rusefi/hw_55_te/version.txt

# this file is related to https://github.com/rusefi/kicad-libraries/blob/master/generate_diffs.sh
0.0
