rusefi/hw_55_te/microrusefi55adapter.pdf

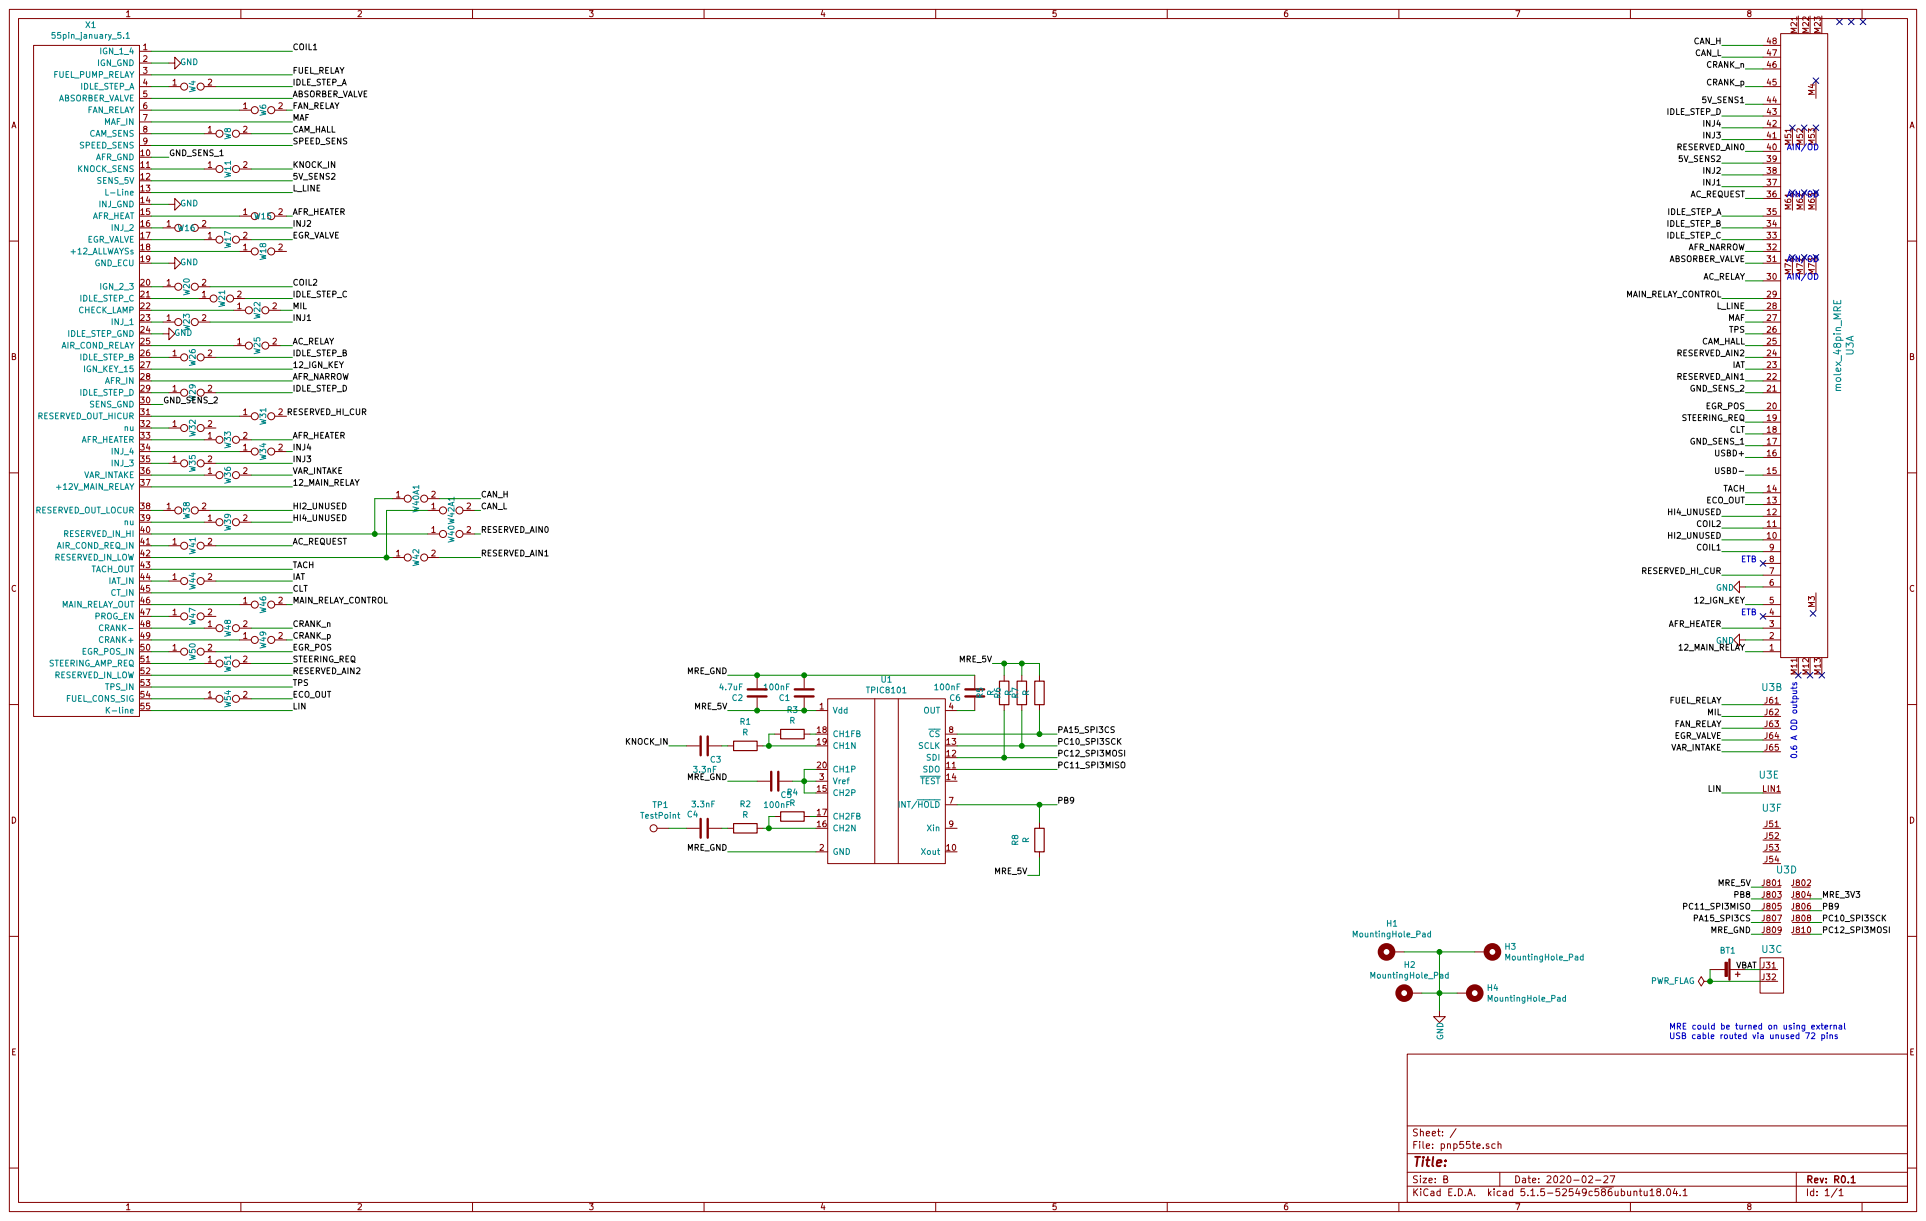
[picture p2: page 1]

MRE could be turned on using external
USB cable routed via unused 72 pins
