rusefi/hw_55_te/pnp55te.kicad_pcb

## KiCad design pnp55te.kicad_pcb (2020-08-17)

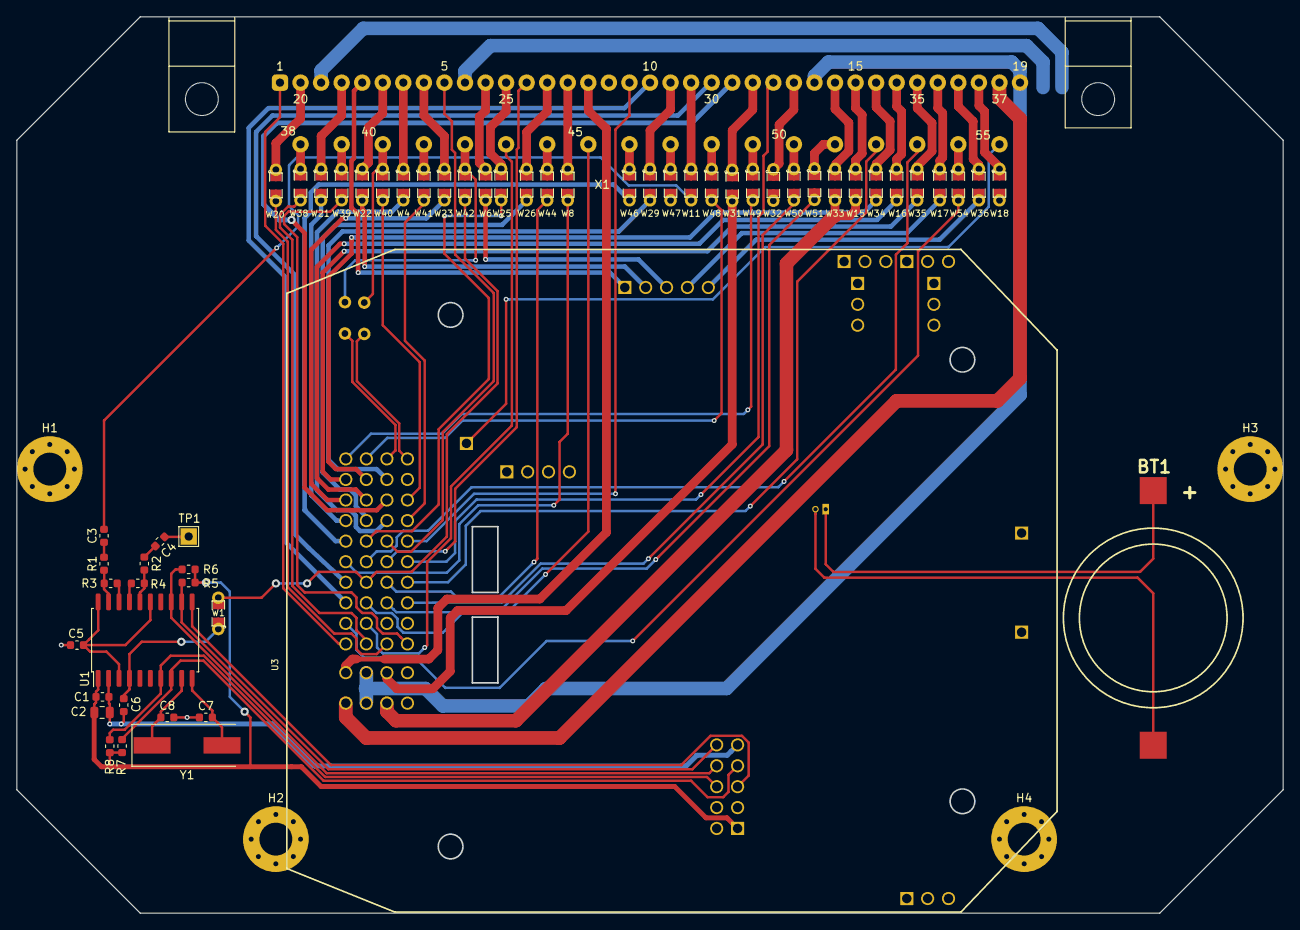
[picture p3: board pnp55te.kicad_pcb from above]

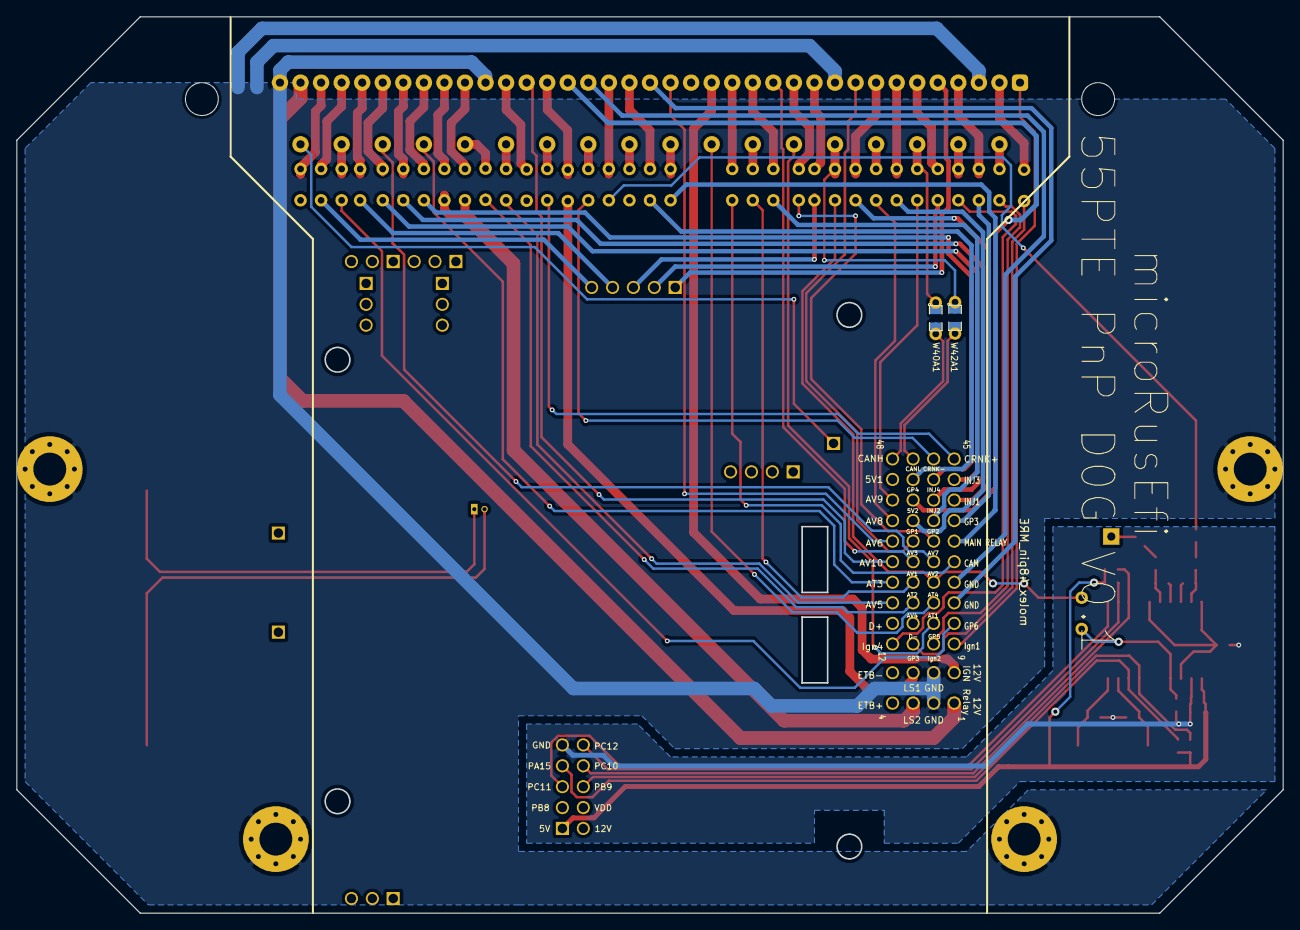
[picture p4: board pnp55te.kicad_pcb from below]

Board: 2 copper layers, 154.0 x 109.0 mm, 63 parts (2 on the bottom side), 103 nets.

Parts:
BT1: Battery_Cell; BATT_CR2032_MPD
C1, C5, C6: 100nF; C_0603_1608Metric
C2: 4.7uF; C_0805_2012Metric
C3, C4: 3.3nF; C_0603_1608Metric
C7, C8: 18pF; C_0603_1608Metric
H1, H2, H3, H4: MountingHole_Pad; MountingHole_4mm_Pad_Via
R1, R2, R3, R4, R5, R6, R7, R8: R; R_0603_1608Metric
TP1: TestPoint; TestPoint_THTPad_2.0x2.0mm_Drill1.0mm
U1: TPIC8101; SOIC-20W_7.5x12.8mm_P1.27mm
U3: molex_48pin_MRE; Molex_48_MRE_clean
W1: n.a. TestPoint_2Pole; SM0805_jumper
W4, W6, W8, W11, W15, W16, W17, W18, W20, W21, W22, W23, W25, W26, W29, W31, W32, W33, W34, W35, W36, W38, W39, W40, W40A1, W41, W42, W42A1, W44, W46, W47, W48, W49, W50, W51, W54: TestPoint_2Pole; SM0805_jumper
X1: 55pin_january_5.1; TE_963063-2
Y1: 8MHz; Crystal_SMD_HC49-SD

Connections:
/5V_SENS2: U3.39, X1.12
/12_IGN_KEY: U3.5, X1.27
/12_MAIN_RELAY: U3.1, X1.37
/ABSORBER_VALVE: U3.31, X1.5
/AC_RELAY: U3.30, W25.2
/AC_REQUEST: U3.36, W41.2
/AFR_HEATER: U3.3, W15.2, W33.2
/AFR_NARROW: U3.32, X1.28
/CAM_HALL: U3.25, W8.2
/CAN_H: U3.48, W40A1.2
/CAN_L: U3.47, W42A1.2
/CLT: U3.18, X1.45
/COIL1: U3.9, X1.1
/COIL2: U3.11, W20.2
/CRANK_n: U3.46, W48.2
/CRANK_p: U3.45, W49.2
/ECO_OUT: U3.13, W54.2
/EGR_POS: U3.20, W50.2
/EGR_VALVE: U3.J64, W17.2
/FAN_RELAY: U3.J63, W6.2
/FUEL_RELAY: U3.J61, X1.3
/GND_SENS_1: U3.17, X1.10
/GND_SENS_2: U3.21, X1.30
/HI2_UNUSED: U3.10, W38.2
/HI4_UNUSED: U3.12, W39.2
/IAT: U3.23, W44.2
/IDLE_STEP_A: U3.35, W4.2
/IDLE_STEP_B: U3.34, W26.2
/IDLE_STEP_C: U3.33, W21.2
/IDLE_STEP_D: U3.43, W29.2
/INJ1: U3.37, W23.2
/INJ2: U3.38, W16.2
/INJ3: U3.41, W35.2
/INJ4: U3.42, W34.2
/KNOCK_IN: C3.2, W11.2
/LIN: U3.LIN1, X1.55
/L_LINE: U3.28, X1.13
/MAF: U3.27, X1.7
/MAIN_RELAY_CONTROL: U3.29, W46.2
/MIL: U3.J62, W22.2
/MRE_5V: C1.1, C2.1, R5.1, R6.1, R7.1, R8.2, U1.1, U3.J801
/MRE_GND: C1.2, C2.2, C5.2, C6.2, C7.2, C8.2, U1.2, U3.J809
/PA15_SPI3CS: R7.2, U1.8, U3.J807
/PB9: R8.1, U1.7, U3.J806
/PC10_SPI3SCK: R6.2, U1.13, U3.J808
/PC11_SPI3MISO: U1.11, U3.J805
/PC12_SPI3MOSI: R5.2, U1.12, U3.J810
/RESERVED_AIN0: U3.40, W40.2
/RESERVED_AIN1: U3.22, W1.2, W42.2
/RESERVED_AIN2: U3.24, X1.52
/RESERVED_HI_CUR: U3.7, W31.2
/STEERING_REQ: U3.19, W51.2
/TACH: U3.14, X1.43
/TPS: U3.26, X1.53
/VAR_INTAKE: U3.J65, W36.2
/VBAT: BT1.1, U3.J31
GND: H1.1, H2.1, H3.1, H4.1, U3.2, U3.6, X1.2, X1.14, X1.19, X1.24
unnamed: BT1.2, U3.J32
unnamed: C3.1, R1.2
unnamed: C4.1, TP1.1
unnamed: C4.2, R2.2
unnamed: C5.1, U1.3, U1.15, U1.20
unnamed: C6.1, U1.4, W1.1
unnamed: C7.1, U1.10, Y1.2
unnamed: C8.1, U1.9, Y1.1
unnamed: R1.1, R3.2, U1.19
unnamed: R2.1, R4.2, U1.16
unnamed: R3.1, U1.18
unnamed: R4.1, U1.17
unnamed: W4.1, X1.4
unnamed: W6.1, X1.6
unnamed: W8.1, X1.8
unnamed: W11.1, X1.11
unnamed: W15.1, X1.15
unnamed: W16.1, X1.16
unnamed: W17.1, X1.17
unnamed: W18.1, X1.18
unnamed: W20.1, X1.20
unnamed: W21.1, X1.21
unnamed: W22.1, X1.22
unnamed: W23.1, X1.23
unnamed: W25.1, X1.25
unnamed: W26.1, X1.26
unnamed: W29.1, X1.29
unnamed: W31.1, X1.31
unnamed: W32.1, X1.32
unnamed: W33.1, X1.33
unnamed: W34.1, X1.34
unnamed: W35.1, X1.35
unnamed: W36.1, X1.36
unnamed: W38.1, X1.38
unnamed: W39.1, X1.39
unnamed: W40.1, W40A1.1, X1.40
unnamed: W41.1, X1.41
unnamed: W42.1, W42A1.1, X1.42
unnamed: W44.1, X1.44
unnamed: W46.1, X1.46
unnamed: W47.1, X1.47
unnamed: W48.1, X1.48
unnamed: W49.1, X1.49
unnamed: W50.1, X1.50
unnamed: W51.1, X1.51
unnamed: W54.1, X1.54
