rusefi/hw_55_te/(threads)

Thread 6 (2020-05-06):

TPIC8101 OUT is connected to nothing

mck1117, 2020-05-06:

rusefi, 2020-05-11:
@dron0gus @jharvey ping

dron0gus, 2020-05-12:
Idea was to read output data over spi using extended mode.

mck1117, 2020-05-12:
the software for that doesn't exist yet, so why not wire up the analog output?

dron0gus, 2020-05-12:
AFAIR I ran out of analog inputs on this board.

Thread 12 (2020-06-23):

M20 e30 gap analysis

rusefi, 2020-06-23:
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

rusefi, 2020-06-23:
https://jlcpcb.com/parts/componentSearch?searchTxt=NCV1124

@mck1117 says "for a basic VR like that we can use an NCV1124 which JLC can assemble"

OrchardPerformance, 2020-06-23:
Gap analysis done here: https://github.com/rusefi/rusefi/wiki/MREAdapter55
This matches the pinout chart on the google sheet. https://docs.google.com/spreadsheets/d/1QUvXrv6kT4efWD30Bd7aLbxDYq-vGJzSjS8gyzylZiU/edit#gid=0

The January/M1.5.4 is quite different to the other early euro motronics for the M20/M30 and Vauxhall.
Suggest we don't try to have one size fits both and make the euro motronics a proteus board for the following reasons:
1. MRE cannot handle the batch injectors that the 6 cylinder engines have (3 injectors on one output)
2. PCB/case size on euro engines is larger, plenty of room for the Proteus board.
3. Euro 55 pin shares a lot of hardware with the 88 pin (which has to be proteus), we could unify some outputs/schematics
4. Euro PNP market is less cost sensitive for these targets, in this case extra features > lower cost
5. using proteus avoids confusion between the MRE based January board and the proteus based Euro board.

Probably some other things that don't jump to mind right now.
