rusefi/hw_55_te/(commit log)

2020-03-04 blank project
    [pnp55te.kicad_pcb, pnp55te.sch]
2020-03-04 board outline
2020-04-03 Update kicad-libraries
2020-04-03 PNP adapter V0.1
    [pnp55te.kicad_pcb, pnp55te.sch]
2020-04-11 Add holes for caps on bottom of MRE (#5)
    [pnp55te.kicad_pcb]
2020-04-25 fixed missing libs, misc changes.
    [pnp55te.kicad_pcb, pnp55te.sch]
2020-04-25 Added gerbers files.
    [pnp55te.kicad_pcb]
2020-04-25 updated JLC BOM information
    [pnp55te.sch]
2020-04-25 More BOM updates
    [pnp55te.sch]
2020-04-25 updated TPIC8108 knock chip resistors and caps.
    [pnp55te.sch]
2020-04-27 Updated GND flood
    [pnp55te.kicad_pcb, pnp55te.sch]
2020-04-27 Updated MRE footprint.
    [pnp55te.kicad_pcb]
2020-08-16 # this file is related to https://github.com/rusefi/kicad-libraries/blob/master/generate_diffs.sh
2020-08-16 Sorry, revert these changes
    I do not want ONE-BIG-SINGLE ground plane. Sorry.
    [pnp55te.kicad_pcb, pnp55te.sch]
2020-08-16 Oscilator for knock sensor, route knock sensor out to AIN, misc fixes
    [pnp55te.kicad_pcb, pnp55te.sch]
